surfer-max/SpotNik/F2TUN2BKOZRGQVP.jpg

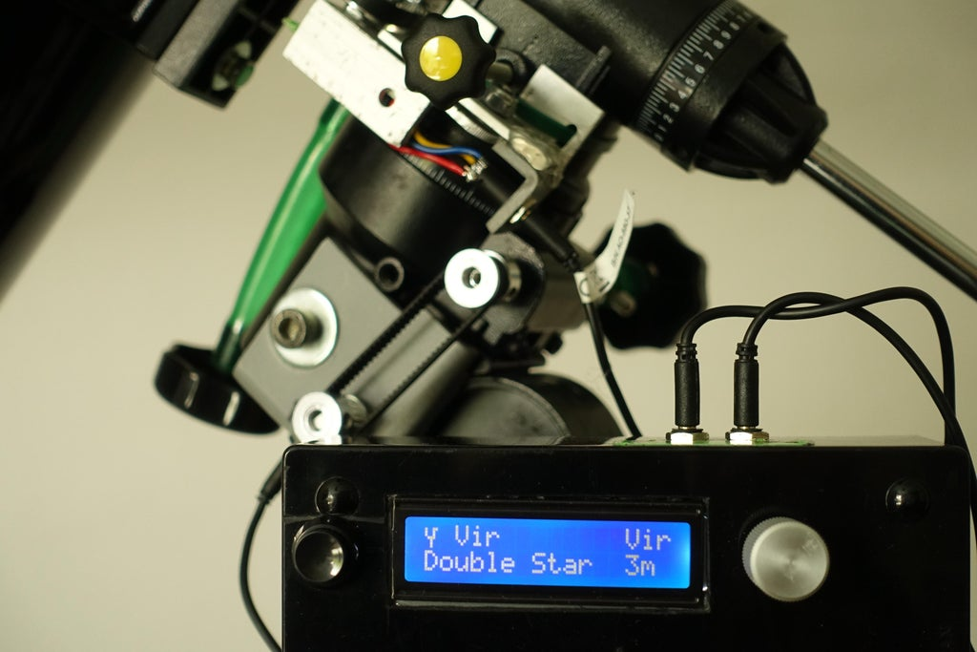
F2TUN2BKOZRGQVP.jpg
