surfer-max/SpotNik/FJV54ZKKOZRGQVQ.jpg

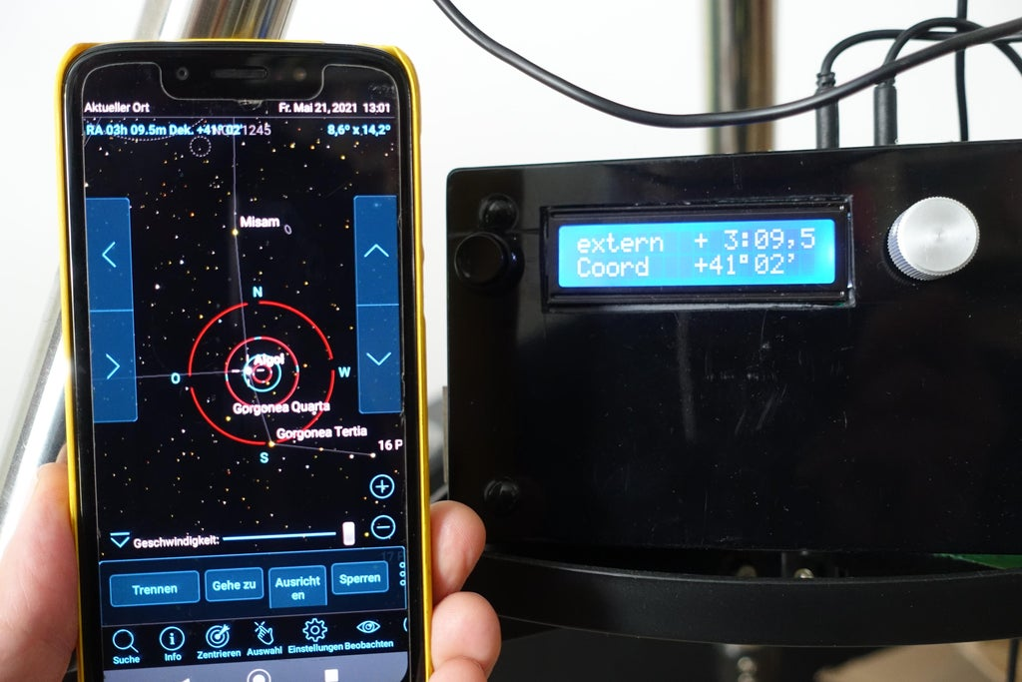
FJV54ZKKOZRGQVQ.jpg
