surfer-max/SpotNik/spotnik.ino

 /* ///////////////////////////////////////////////////////////////////////////////////
  SpotNik - by Max Reinecke 
  Created: May 2021
  SpotNik is software for a stepto system for telescopes

    This program is free software: you can redistribute it and/or modify
    it under the terms of the GNU General Public License as published by
    the Free Software Foundation, either version 3 of the License, or
    (at your option) any later version.
    This program is distributed in the hope that it will be useful,
    but WITHOUT ANY WARRANTY; without even the implied warranty of
    MERCHANTABILITY or FITNESS FOR A PARTICULAR PURPOSE.  See the
    GNU General Public License for more details.
    You should have received a copy of the GNU General Public License
    along with this program.  If not, see <http://www.gnu.org/licenses/>.
  /////////////////////////////////////////////////////////////////////////////////*/
#define VERSION 2.0

//###############################################################################################################
// to be changed by user according to EQ mount - see instructions
// total numbers of impulse of the rotary encoder of RA axis when turned 24h 
#define IMPULSE24HRA 2772 // 6h - 690 Impulse --> 24h - 4 * 693 = 2772 / ~ 1:138
//  total numbers of impulse of the rotary encoder of DEC axis when turned 360° // +/- for correct direction 
#define IMPULSE360DEGDEC 1784  // 90° - 446 Impulse --> 360° - 4 * 446 = 1784 / ~ 1:88
//###############################################################################################################

#include <LiquidCrystal.h> // I2C LCD arbeitet nicht vernünftig mit Rotary Encoder zusammen,daher normales nehmen
#include <EEPROM.h> 
//#include <MemoryFree.h> // only used for testing

//###############################################################################################################
// LCD
#define LCD_CONTRAST_PIN 11 //  LCD contrast - V0 // use high frequency PWM to avoid flickering (Leonardo,Micro,Yún 3 and 11: 980 Hz // Mega pins 4 and 13: 980 Hz) 
#define LCD_BACKLIGHT_PIN 10 // LCD backlight - LCD A

// EEPROM
#define EEPROM_SIGNATURE 117 // value 0-255 (byte) - signature/mark to recognize if the value fits to this sketch
#define EEPROM_VALUE_ADDR_SIGNATURE 0 

// rotary enoder HMI 
#define ROTARY_SW 3 // use interrupt pin - digital pins for interrupts on Micro,Leonardo and other 32u4 based 0,1,2,3,7
#define ROTARY_DT 4 
#define ROTARY_CLK 5 

// Sensor RA
#define SENS_RA_DT A0 // analog pins used as UNO has not that many digital pins
#define SENS_RA_CLK A1 

// Sensor DEC
#define SENS_DEC_DT A2 
#define SENS_DEC_CLK A3 

// LX200 connection
#define BT_SWITCH 2

//###############################################################################################################
// lookup table with names of deep sky objects
//###############################################################################################################
struct DSONameStruct
{
  char objectName[9];
};

const struct DSONameStruct DSO_NAME_PROGMEM[202] PROGMEM = 
{
{"3C273"},
{"B"},
{"IC"},
{"M"},
{"NGC"},
{"#a"},
{"#aA"},
{"#aB"},
{"#b"},
{"#c"},
{"#d"},
{"#e"},
{"#e1"},
{"#e2"},
{"#g"},
{"#h"},
{"#i"},
{"#j"},
{"#k"},
{"#l"},
{"#m"},
{"#n"},
{"#o"},
{"#p"},
{"#q"},
{"#r"},
{"#s"},
{"#t"},
{"#u"},
{"#w"},
{"#x"},
{"#z"},
{"AC"},
{"Achernar"},
{"Acrab"},
{"Acrux"},
{"Adhara"},
{"Agena"},
{"Alamak"},
{"Aldebara"},
{"Alderami"},
{"AlDhanab"},
{"Algenib"},
{"Algieba"},
{"Algol"},
{"Alhena"},
{"Alioth"},
{"Alkaid"},
{"AlNair"},
{"Alnilam"},
{"Alnitak"},
{"Alphard"},
{"Alphecca"},
{"Alpherat"},
{"Alsuhail"},
{"Altair"},
{"Aludra"},
{"Ankaa"},
{"Antares"},
{"AQ"},
{"Arcturus"},
{"Arneb"},
{"Aspidisk"},
{"Atria"},
{"Avior"},
{"AW"},
{"AX"},
{"BD"},
{"Becrux"},
{"Bellatri"},
{"Betelgeu"},
{"BF"},
{"BG"},
{"BL"},
{"BM"},
{"BX"},
{"Canopus"},
{"Capella"},
{"Caph"},
{"Castor"},
{"Cih"},
{"CY"},
{"Deneb"},
{"DenebKai"},
{"Denebola"},
{"Diphda"},
{"DR"},
{"Dschubba"},
{"Dubhe"},
{"EL"},
{"ElNath"},
{"Eltanin"},
{"Enif"},
{"FO"},
{"Fomalhau"},
{"FU"},
{"Gacrux"},
{"Gemma"},
{"Gienah"},
{"Girtab"},
{"GK"},
{"GY"},
{"H"},
{"Hadar"},
{"Hamal"},
{"Han"},
{"HD"},
{"HJ"},
{"HK"},
{"HN"},
{"Izar"},
{"JC"},
{"KausAust"},
{"Kochab"},
{"KooShe"},
{"Markab"},
{"Menkalin"},
{"Menkar"},
{"Menkent"},
{"Merak"},
{"Miaplaci"},
{"Mimosa"},
{"Mintaka"},
{"Mirach"},
{"Mirfak"},
{"Mirzam"},
{"Mizar"},
{"Naos"},
{"NQ"},
{"NSV"},
{"Nunki"},
{"O#F"},
{"Peacock"},
{"Phecda"},
{"Polaris"},
{"Pollux"},
{"Procyon"},
{"PZ6"},
{"R"},
{"RasAlhag"},
{"Regulus"},
{"Rigel"},
{"RigilKen"},
{"RR"},
{"RS"},
{"RT"},
{"RU"},
{"RV"},
{"RX"},
{"RY"},
{"RZ"},
{"S"},
{"S605"},
{"Sabik"},
{"Sadr"},
{"Saiph"},
{"SAO"},
{"Sargas"},
{"Scheat"},
{"Schedar"},
{"Shaula"},
{"SHJ"},
{"Sirius"},
{"Spica"},
{"SS"},
{"ST"},
{"SU"},
{"SV"},
{"SY"},
{"SZ"},
{"T"},
{"TT"},
{"TU"},
{"Tureis"},
{"TW"},
{"TX"},
{"U"},
{"UU"},
{"UV"},
{"UX"},
{"UY"},
{"V"},
{"Vega"},
{"VW"},
{"VX"},
{"VY"},
{"W"},
{"Wei"},
{"Wezen"},
{"WO"},
{"WW"},
{"WX"},
{"WZ"},
{"X"},
{"XS"},
{"XX"},
{"Y"},
{"Z"},
{"Zozma"},
{"β648"},
{"#F"},
{"extern"}
};
//###############################################################################################################

//###############################################################################################################
// data of deep sky objects
//###############################################################################################################
struct DSOstruct
{
  byte objectPreFixNameNo; // number of name for lookup table
  unsigned int objectNumber; // if name contains a number
  byte objectTypeMagnitude; // object type & magnitude coded in one byte
  byte objectConst; // constellation of object
  unsigned int objectRA; //HHMM(SS/6)
  int objectDEC; //sHHMM
};

DSOstruct myTarget; // object to store data of selected target
DSOstruct myReference; // object to store data of selected target

const unsigned int DSO_PROGMEM_size = 1204;
const struct DSOstruct DSO_PROGMEM[DSO_PROGMEM_size] PROGMEM = 
{
{1, 0, 27, 86, 12291, 203},
{2, 33, 42, 60, 5409, -228},
{2, 65, 42, 77, 18027, -2750},
{2, 86, 42, 59, 17196, -2642},
{3, 342, 54, 11, 3468, 6806},
{3, 405, 66, 8, 5165, 3421},
{3, 410, 64, 8, 5227, 3325},
{3, 434, 67, 60, 5410, -227},
{3, 1396, 74, 16, 21391, 5730},
{3, 4406, 95, 50, 14224, -4409},
{3, 5067, 64, 31, 20508, 4421},
{3, 5146, 80, 31, 21534, 4716},
{4, 1, 106, 78, 5345, 2201},
{4, 2, 119, 5, 21335, -49},
{4, 3, 118, 30, 13422, 2823},
{4, 4, 117, 72, 16236, -2632},
{4, 5, 118, 74, 15186, 205},
{4, 6, 130, 72, 17403, -3215},
{4, 7, 129, 72, 17539, -3448},
{4, 8, 75, 77, 18037, -2423},
{4, 9, 120, 59, 17192, -1831},
{4, 10, 119, 59, 16571, -406},
{4, 11, 132, 73, 18511, -616},
{4, 12, 118, 59, 16472, -157},
{4, 13, 118, 40, 16417, 3628},
{4, 14, 120, 59, 17376, -315},
{4, 15, 118, 62, 21300, 1210},
{4, 16, 76, 74, 18188, -1347},
{4, 17, 76, 77, 18208, -1611},
{4, 18, 133, 77, 18199, -1708},
{4, 19, 119, 59, 17026, -2616},
{4, 20, 76, 77, 18027, -2258},
{4, 21, 132, 77, 18042, -2229},
{4, 22, 117, 77, 18364, -2354},
{4, 23, 132, 77, 17571, -1859},
{4, 24, 129, 77, 18266, -1823},
{4, 25, 131, 77, 18318, -1907},
{4, 26, 134, 73, 18452, -924},
{4, 27, 91, 88, 19596, 2243},
{4, 28, 119, 77, 18245, -2452},
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
};
//###############################################################################################################

//###############################################################################################################
// variables for button - instead of bounce lib - save flash memory
//###############################################################################################################
const int DEBOUNCE_DELAY = 50;   // the debounce time; increase if the output flickers
int lastSteadyState = LOW;       // the previous steady state from the input pin
int lastFlickerableState = LOW;  // the previous flickerable state from the input pin
int currentState;                // the current reading from the input pin
unsigned long lastDebounceTime = 0;  // the last time the output pin was toggled
unsigned long lastPressedTime = 0;
//###############################################################################################################

//###############################################################################################################
// LCD - VSS - GND // VCC - 5V // RW - GND // K - GND
//###############################################################################################################
const byte rs = 12;
const byte en = 13;
const byte d4 = 9; 
const byte d5 = 8; 
const byte d6 = 7; 
const byte d7 = 6; 
LiquidCrystal lcd(rs,en,d4,d5,d6,d7);
byte myLCDbacklight = 255;
byte myLCDcontrast = 100;
//###############################################################################################################

//###############################################################################################################
// variables to steer menu
//###############################################################################################################
byte myDisplayMode = 0; 
const char *const menuTopic[] = {"DEC", "Align","Target","Region","Const","Brightness","Contrast","Sensors","LX200"};
const byte menuTopic_size = sizeof(menuTopic) / sizeof(menuTopic[0]);
byte myMenuTopicNo = 0;
//###############################################################################################################

//###############################################################################################################
// definition of special / greek characters - for LCD 1602 chinese version - adapt to your LCD if needed
//###############################################################################################################
// used lcd is like this https://www.waveshare.com/datasheet/LCD_en_PDF/LCD1602.pdf (see 14. font table)
const char ch_deg = (char)(223); // degree symbol 
const char ch_sigma = (char)(246); // uppercase Sigma 
// greek alphabet 1-24 = α β γ δ ε ζ η θ ι κ λ μ ν ξ ο π ρ σ τ υ φ χ ψ ω
// maximum 8 custom characters
// γ
char ch_def_1 = 'g'; // for identificatrion & replacement
byte ch_custom_1[] = {
  B00000,
  B10011,
  B10010,
  B10010,
  B01110,
  B00100,
  B00100,
  B00100
};
// δ
char ch_def_2 = 'd';
byte ch_custom_2[] = {
  B00110,
  B01001,
  B00100,
  B01110,
  B10001,
  B10001,
  B01110,
  B00000
};
// ζ
char ch_def_3 = 'z';
byte ch_custom_3[] = {
  B01111,
  B00010,
  B00100,
  B01000,
  B01000,
  B01111,
  B00001,
  B00110
};
// λ
char ch_def_4 = 'l';
byte ch_custom_4[] = {
  B01100,
  B00100,
  B00100,
  B01010,
  B01010,
  B10001,
  B10001,
  B00000
};
// ξ
char ch_def_5 = 'x';
byte ch_custom_5[] = {
  B11111,
  B00100,
  B01000,
  B00111,
  B01000,
  B10000,
  B11111,
  B00010
};
// φ
char ch_def_6 = 'p';
byte ch_custom_6[] = {
  B00000,
  B10111,
  B10101,
  B10101,
  B10101,
  B01110,
  B00100,
  B00100
};
// ψ
char ch_def_7 = 's';
byte ch_custom_7[] = {
  B00000,
  B00100,
  B10101,
  B10101,
  B10101,
  B01110,
  B00100,
  B00100
};
// Δ
char ch_def_8 = 'D';
byte ch_custom_8[] = {
  B00000,
  B00100,
  B01010,
  B01010,
  B10001,
  B10001,
  B11111,
  B00000
};

// lookup table placeholder chars with greek symbols
struct greekSymbols {
  char originalChar;
  char replaceChar;  
};

const unsigned int greekSymbols_size = 26;
const struct greekSymbols greekSymbols[greekSymbols_size]  = 
{
  {'a',(char)(224)},// α
  {'b',(char)(226)},// β 
  {'g','g'},// γ custom character
  {'d','d'},// δ custom character
  {'e',(char)(227)},// ε
  {'z','z'},// ζ custom character
  {'j','n'},// η
  {'h',(char)(242)},// θ
  {'i','l'},// ι
  {'k','k'},// κ
  {'l','l'},// λ custom character
  {'m',(char)(228)},// μ
  {'n','v'},// ν
  {'x','x'},// ξ custom character
  {'o','o'},// ο
  {'p',(char)(247)},// π
  {'r',(char)(230)},// ρ
  {'s',(char)(229)},// σ
  {'t','t'},// τ
  {'y',(char)(232)},// υ
  {'q','p'},// φ custom character
  {'c','x'},// χ
  {'w','s'},// ψ custom character
  {'u','w'},
  {'F',(char)(246)},// Σ
  {'D','/'} // Δ
}; 
//###############################################################################################################  

//###############################################################################################################
// definition of constellation names
//###############################################################################################################
struct constStruct { char constName[4];};
constStruct myConstellation;
const unsigned int constStruct_size = 89;
const struct constStruct const_PROGMEM[constStruct_size] PROGMEM = {
{"all"},{"And"},{"Ant"},{"Aps"},{"Aql"},{"Aqr"},{"Ara"},{"Ari"},{"Aur"},{"Boo"},{"Cae"},{"Cam"},{"Cap"},{"Car"},{"Cas"},{"Cen"},{"Cep"},{"Cet"},{"Cha"},{"Cir"},
{"CMa"},{"CMi"},{"Cnc"},{"Col"},{"Com"},{"CrA"},{"CrB"},{"Crt"},{"Cru"},{"Crv"},{"CVn"},{"Cyg"},{"Del"},{"Dor"},{"Dra"},{"Equ"},{"Eri"},{"For"},{"Gem"},{"Gru"},
{"Her"},{"Hor"},{"Hya"},{"Hyi"},{"Ind"},{"Lac"},{"Leo"},{"Lep"},{"Lib"},{"LMi"},{"Lup"},{"Lyn"},{"Lyr"},{"Men"},{"Mic"},{"Mon"},{"Mus"},{"Nor"},{"Oct"},{"Oph"},
{"Ori"},{"Pav"},{"Peg"},{"Per"},{"Phe"},{"Pic"},{"PsA"},{"Psc"},{"Pup"},{"Pyx"},{"Ret"},{"Scl"},{"Sco"},{"Sct"},{"Ser"},{"Sex"},{"Sge"},{"Sgr"},{"Tau"},{"Tel"},
{"TrA"},{"Tri"},{"Tuc"},{"UMa"},{"UMi"},{"Vel"},{"Vir"},{"Vol"},{"Vul"}};
byte myConstellationNo = 0;
String myConstellationName = ""; 
//###############################################################################################################

//###############################################################################################################
// object type name and variables for deep sky objects
//###############################################################################################################
const char* myObjectTypeName[]={"Quasar","Dark Nebula","Galaxy","Bright Neb","Clust + Neb","Planet Neb","SN Rem","Glob Cluster","Open Cluster","Double Star","Red Star","Reference","any"};
unsigned int myRefNo = 0; // number of selected reference star 
unsigned int  myTargetNo = 0; // number of selected target
//###############################################################################################################

//###############################################################################################################
// definition of cellestial regions = constellations of seasons defined in groups (as in Deep Sky Atlas) to filter targets and reference stars 
//###############################################################################################################
// constellation for which deep sky objects exist in the list 0 = all
const byte myAllCONST[]={0,1,2,4,5,6,7,8,9,11,12,13,14,15,16,17,19,20,21,22,23,24,25,26,27,28,29,30,31,32,33,34,35,36,37,38,39,40,41,42,44,45,46,47,48,49,50,51,52,54,55,57,59,60,61,62,63,64,66,67,68,69,71,72,73,74,75,76,77,78,80,81,83,84,85,86,88};
const byte myAllCONST_size = sizeof(myAllCONST) / sizeof(myAllCONST[0]);
// North - UMI,UMA,DRA,CEP,CAS,CAM
const byte myNorthCONST[]={84,83,34,16,14,11};
const byte myNorthCONST_size = sizeof(myNorthCONST) / sizeof(myNorthCONST[0]);
// Spring - LEO,LMI,SEX,HYA,CVN,COM,VIR,CRT,CRV,BOO,CRB,SER
const byte mySpringCONST[]={46,49,75,42,30,24,86,27,29,9,26,74};
const byte mySpringCONST_size = sizeof(mySpringCONST) / sizeof(mySpringCONST[0]);
// Summer - HER,LYR,OPH,SCO,CYG,VUL,SGE,DEL,EQU,AQL,SCT,SER,SGR,CAP
const byte mySummerCONST[]={40,52,59,72,31,88,76,32,35,4,73,74,77,12};
const byte mySummerCONST_size = sizeof(mySummerCONST) / sizeof(mySummerCONST[0]);
// Autumn - LAC,PEG,AQR,PSA,AND,TRI,PER,ARI,PSC,CET,SCL,FOR,ERI
const byte myAutumnCONST[]={45,62,5,66,1,81,63,7,67,17,71,37,36};
const byte myAutumnCONST_size = sizeof(myAutumnCONST) / sizeof(myAutumnCONST[0]);
// Winter - AUR,TAU,ORI,LEP,LYN,GEM,CMI,MON,CMA,PUP,CNC
const byte myWinterCONST[]={8,78,60,47,51,38,21,55,20,68,22};
const byte myWinterCONST_size = sizeof(myWinterCONST) / sizeof(myWinterCONST[0]);
// South - ANT,VEL,CAR,VOL,CHA,MUS,CRU,CEN,CRU,TRA,LUP,NOR,ARA,SCO,SGR,CRA,TEL,MIC,IND,PAV,GRU,PHE,SCL,FOR,ERI,HOR,RET,HYI,TUC,DOR,CAE,COL,PUP,PYX,PIC,MEN,APS,OCT
const byte mySouthCONST[]={2,85,13,28,15,28,80,50,57,6,72,77,25,54,44,61,39,64,71,37,36,41,33,23,68,69,65};
const byte mySouthCONST_size = sizeof(mySouthCONST) / sizeof(mySouthCONST[0]);
const char* myregionNAME[]={"all","North","Spring","Summer","Autumn","Winter","South"}; // no south to save flash
const byte regionArraySize = sizeof(myregionNAME) / sizeof(myregionNAME[0]); // Anzahl der Einträge
byte myRegionNo = 0; // all - 0; North - 1; .... ; South - 6
String myregionName = "";
//###############################################################################################################

//###############################################################################################################
// variables for calculation of position // all positions are calculated in seconds
//###############################################################################################################
long myRefStartTimeSec = 0; // Startzeit beim Setzen des Referenzsterns in Sekunden
long myCurrentRAsec = 0; // meine aktuelle Rektaszension in Sekunden
long myCurrentDECsec = 0; // meine aktuelle Deklination in Sekunden
long myLastRAsec = 0; // meine letzte Rektaszension in Sekunden 
long myLastDECsec = 0; // meine letzte Deklination in Sekunden 
long myReferenceRAsec = 0; // meine Rektaszensionsreferenz in Sekunden
long myReferenceDECsec = 0; // meine Deklinationsreferenz in Sekunden
long mySensorRAsec = 0; // Sensorwert der Rektaszension in Sekunden
long mySensorDECsec = 0; // Sensorwert der Deklination in Sekunden
long myTargetRAsec = 0; // Rektaszension des Ziels in Sekunden
long myTargetDECsec = 0; // Deklination des Ziels in Sekunden
const int secPerStepRA = 86400L / IMPULSE24HRA; // defines how many seconds RA is changed per rotary step //  (24h * 3600sec = 86400sec) / (1:139 * 20 impulse = 2780) --> 31,079 sec / i
const int secPerStepDEC = 1296000L / IMPULSE360DEGDEC; // defines how many seconds DEC is changed per rotary step //  (360° * 3600sec = 1296000sec) / (1:96 * 20 impulse = 1920) / --> 675 sec / i
int myDirectionDEC = 1; // saves the value of the direction of the DEC axis, important if the telescope is turned over
//###############################################################################################################

//###############################################################################################################
// for rotary encoders
//###############################################################################################################
static uint8_t prevNextCode_ROT = 0;
static uint16_t store_ROT=0;
static uint8_t prevNextCode_RA = 0;
static uint16_t store_RA=0;
static uint8_t prevNextCode_DEC = 0;
static uint16_t store_DEC=0;
static int8_t val_ROT,val_RA,val_DEC; 
int myImpulseRA = 0,myImpulseDEC = 0;
int myLastImpulseRA = 0,myLastImpulseDEC = 0;
const int8_t enc_table[] = {0,1,1,0,1,0,0,1,1,0,0,1,0,1,1,0};
//###############################################################################################################

//###############################################################################################################
// variables for LX200
//###############################################################################################################
byte statusLX200 = 0; // 0 - BT switched off / 1 - BT switched on / 2 - connected via BT & LX200 (frequent connect to LX200)
byte statusLX200old = 0;
byte btStatus = 0; // 0 - off / 1 - on
unsigned long lastLX200Message = 0;
DSOstruct externalObject; // instance LX200 object
//###############################################################################################################

//###############################################################################################################
// setup
//###############################################################################################################
void setup()
{
  // for LX200 protocol & debugging
  Serial.begin (9600);
 // while(!Serial); // attention - only for debugging when in use with IDE!
 // Serial.println(F("started"));

  getSettingsFromEeprom(); // load settings (brightness,contrast,...)
  setReference(); // set reference object to saved values
  setTarget(); // set target object to saved values
  setupLCD();
  createCustomCharacters();
  setupRotaryEncoders();
  initExternalObject();
}

// software reset https://www.instructables.com/two-ways-to-reset-arduino-in-software/
void(* resetFunc) (void) = 0;//declare reset function at address 0

void setupLCD()
{
  lcd.begin(16,2);
  updateLCD();   
  pinMode(LCD_BACKLIGHT_PIN,OUTPUT);
  analogWrite(LCD_CONTRAST_PIN, myLCDcontrast); //set contrast
}

//Creating custom characters in CG-RAM
void createCustomCharacters()
{
  lcd.createChar(1 ,ch_custom_1); 
  lcd.createChar(2 ,ch_custom_2); 
  lcd.createChar(3 ,ch_custom_3); 
  lcd.createChar(4 ,ch_custom_4); 
  lcd.createChar(5 ,ch_custom_5); 
  lcd.createChar(6 ,ch_custom_6); 
  lcd.createChar(7 ,ch_custom_7);  
  lcd.createChar(8 ,ch_custom_8); 
}

void setupRotaryEncoders()
{
  // HMI rotary encoder button
  pinMode(ROTARY_SW,INPUT_PULLUP); 

  // HMI rotary encoder
  pinMode(ROTARY_CLK,INPUT);
  pinMode(ROTARY_DT,INPUT);

  // it is better to use the integrated pull-ups of KY-040 (this requires "+" to be connected to 5V) - https://forum.arduino.cc/index.php?topic=242356.0 
  // as analog pins are used for rotary encoders - internal pull-ups are additionally used to avoid akward behaviour if not connected to sensors
  // RA rotary encoder
  pinMode(SENS_RA_CLK,INPUT_PULLUP);
  pinMode(SENS_RA_DT,INPUT_PULLUP);
  // DEC rotary encoder
  pinMode(SENS_DEC_CLK,INPUT_PULLUP);
  pinMode(SENS_DEC_DT,INPUT_PULLUP); 

  // switch for BT module
  pinMode(BT_SWITCH, OUTPUT);   
}

// initialise external object struct for receiving via LX200
void initExternalObject()
{
  externalObject.objectPreFixNameNo = 202; // is "external" in DSO PROGMEM
  externalObject.objectNumber = 0; // empty - no number in name
  externalObject.objectTypeMagnitude = 0; 
  externalObject.objectConst = 0; // "all" in constellations
  externalObject.objectRA = 0;
  externalObject.objectDEC = 0;
}
//###############################################################################################################
// \setup
//###############################################################################################################

//###############################################################################################################
// loop
//###############################################################################################################
void loop()
{
  analogWrite(LCD_BACKLIGHT_PIN,myLCDbacklight);   // LCD backlight analogWrite: values from 0 to 255

  updateRotaryEncoderButton();
  updateRotaryEncoders();
  calcCurrentPosition();
  
  if (myDisplayMode == 9) displaySensorValue();
  if (myDisplayMode == 11) displayCurrPos(); 
  if (myDisplayMode == 12) displayTargetPos();
  if (myDisplayMode == 13) displayDiffTargetCurrPos();

  // LX200 status
  updateLX200Status();
  readSendLX200(); 
}
//###############################################################################################################
// \loop
//###############################################################################################################

//###############################################################################################################
// read sensor values
//###############################################################################################################
// reads rotary encoders
void updateRotaryEncoders()
{
  if(val_ROT=read_rotary_ROT()) switchSelection(val_ROT); 
  
  if(val_RA=read_rotary_RA()) 
  {
    mySensorRAsec = mySensorRAsec + val_RA * secPerStepRA;
    myImpulseRA = myImpulseRA + val_RA; // for sensor test
  }
  
  if(val_DEC=read_rotary_DEC()) 
  {
    mySensorDECsec = mySensorDECsec + val_DEC * secPerStepDEC * myDirectionDEC; 
    myImpulseDEC = myImpulseDEC + val_DEC * myDirectionDEC; // for sensor test
  }
}

// reads rotary encoder button
void updateRotaryEncoderButton()
{
  // copy from https://arduinogetstarted.com/tutorials/arduino-button-debounce
  currentState = digitalRead(ROTARY_SW);

  if (currentState != lastFlickerableState) 
  {
    lastDebounceTime = millis();
    lastFlickerableState = currentState;
  }

  if ((millis() - lastDebounceTime) > DEBOUNCE_DELAY) 
  {
    if(lastSteadyState == HIGH && currentState == LOW)
    {
      switchMode();
      updateLCD();
      lastPressedTime = millis();
    }
    else if(lastSteadyState == LOW && currentState == HIGH)
    {
      // if button pressed > 5 seconds -> reset
      if (millis() - lastPressedTime > 5000) resetFunc(); // call reset
    }
    lastSteadyState = currentState;
  } 
}

// read rotary encoder for HMI
// robust rotary encoder reading https://www.best-microcontroller-projects.com/rotary-encoder.html
// A vald CW or  CCW move returns 1,invalid returns 0.
int8_t read_rotary_ROT() 
{
  prevNextCode_ROT <<= 2;
  if (digitalRead(ROTARY_DT)) prevNextCode_ROT |= 0x02;
  if (digitalRead(ROTARY_CLK)) prevNextCode_ROT |= 0x01;
  prevNextCode_ROT &= 0x0f;

  // If valid then store as 16 bit data.
  if  (enc_table[prevNextCode_ROT] ) 
  {
    store_ROT <<= 4;
    store_ROT |= prevNextCode_ROT;
    if ((store_ROT&0xff)==0x2b) return -1;
    if ((store_ROT&0xff)==0x17) return 1;
  }
  return 0;
}

// read rotary encoder for RA
int8_t read_rotary_RA() 
{
  prevNextCode_RA <<= 2;
  if (digitalRead(SENS_RA_DT)) prevNextCode_RA |= 0x02;
  if (digitalRead(SENS_RA_CLK)) prevNextCode_RA |= 0x01;
  prevNextCode_RA &= 0x0f;

  // If valid then store as 16 bit data.
  if  (enc_table[prevNextCode_RA] ) 
  { 
    store_RA <<= 4;
    store_RA |= prevNextCode_RA;
    if ((store_RA&0xff)==0x2b) return -1;
    if ((store_RA&0xff)==0x17) return 1;
  }
  return 0;
}

// read rotary encoder for DEC
int8_t read_rotary_DEC() 
{
  prevNextCode_DEC <<= 2;
  if (digitalRead(SENS_DEC_DT)) prevNextCode_DEC |= 0x02;
  if (digitalRead(SENS_DEC_CLK)) prevNextCode_DEC |= 0x01;
  prevNextCode_DEC &= 0x0f;

  // If valid then store as 16 bit data.
  if  (enc_table[prevNextCode_DEC] ) 
  {
    store_DEC <<= 4;
    store_DEC |= prevNextCode_DEC;
    if ((store_DEC&0xff)==0x2b) return -1;
    if ((store_DEC&0xff)==0x17) return 1;
  }
  return 0;
}
//###############################################################################################################
// read sensor values
//###############################################################################################################


//###############################################################################################################
// get & set of object data
//###############################################################################################################
// returns the type as number of a deep sky object
byte getObjectType(byte typeMagnitude)
{
  return (typeMagnitude / 14); // decoding of object type from typeMagnitude
}

// returns the type as string of a deep sky object
String getObjectTypeName(byte typeMagnitude)
{
  return myObjectTypeName[(typeMagnitude / 14) - 1];
}

// returns the magnitude of a deep sky object
String getMagnitude(byte typeMagnitude)  // calcs the right magnitude - here modulo 14 as coded 
{
  String strFlMag = (String)(typeMagnitude % 14) +  "m";
  return strFlMag; 
}

// returns the name of a constellation as string from a lookup tabel according to its number
String getConstName(int no)
{ 
  constStruct oneConstellation;
  // copy constellations data from PROGMEM into oneConstellation according to no
  memcpy_P (&oneConstellation,&const_PROGMEM[no],sizeof oneConstellation); 
  return (String)oneConstellation.constName;
}

// returns the current constellation for filtering
String getCurrentConstName()
{
  String constellationName;
  constellationName = getConstName(myConstellationNo);
  return constellationName;
}

// returns the current cellestial region
String getSetregionName()
{
  return myregionNAME[myRegionNo];
}

// set reference star
void setReference()
{
  // copy reference data from PROGMEM into myReference according to myRefNo
  memcpy_P (&myReference,&DSO_PROGMEM[myRefNo],sizeof myReference); 
  setReferenceRA_DEC();
}

// RA and DEC of selected target are set
void setReferenceRA_DEC()
{
  // transfer RA / DEC into internal format (seconds)
  myReferenceRAsec = calcRAsecFromRA(myReference.objectRA);
  myReferenceDECsec = calcDECsecFromDEC(myReference.objectDEC);
}

// set target
void setTarget()
{
  // copy reference data from PROGMEM into myTarget according to myTargetNo
  memcpy_P (&myTarget,&DSO_PROGMEM[myTargetNo],sizeof myTarget); 
  setTargetRA_DEC();
}

// RA and DEC of selected target are set
void setTargetRA_DEC()
{
  // transfer RA / DEC into internal format (seconds)
  myTargetRAsec = calcRAsecFromRA(myTarget.objectRA);
  myTargetDECsec = calcDECsecFromDEC(myTarget.objectDEC);
}
//###############################################################################################################
// \get & set of object data
//###############################################################################################################

//###############################################################################################################
// calculations and settings of positions
//###############################################################################################################

// calculation of RA seconds 
unsigned int calcRAsecFromRA(unsigned int ra)
{
    int h = ra / 1000;
    int m = (ra - h * 1000) / 10;
    int s = (ra - h * 1000 - m * 10) * 6;
    unsigned int raSec = h * 3600L + m * 60 + s;
    return raSec;
}

// calculation of DEC seconds
long calcDECsecFromDEC(int dec)
{
    int deg = dec / 100;
    int m = (dec - deg * 100);
    long decSec = deg * 3600L + m * 60;
    return decSec;
}

// calculation of current telescope position
void calcCurrentPosition()
{
   myCurrentRAsec = myReferenceRAsec + myRefStartTimeSec + mySensorRAsec - millis()/1000;
   myCurrentDECsec = myReferenceDECsec + mySensorDECsec;
}

// sets the sensor values to zero - needed for alignment with reference star
void resetSensorTime()
{
    mySensorRAsec = 0; // Sensorwert der Rektaszension
    mySensorDECsec = 0; // Sensorwert der Deklination
    myRefStartTimeSec = millis() / 1000;
}
//###############################################################################################################
// \calculations and settings of positions
//###############################################################################################################

//###############################################################################################################
// display information
//###############################################################################################################

// display the current position
void displayCurrPos()
{
   if (myLastRAsec != myCurrentRAsec || myLastDECsec != myCurrentDECsec)
   {
       myLastRAsec = myCurrentRAsec;
       myLastDECsec = myCurrentDECsec;
       displayRA_DEC("Curr   ","Coord",myCurrentRAsec,myCurrentDECsec);
   }
}

// display position of selected target
void displayTargetPos()
{
  displayRA_DEC(getObjectName(myTarget.objectPreFixNameNo,myTarget.objectNumber,myTarget.objectConst),"Coord",myTargetRAsec,myTargetDECsec);
}

// calulation & display of difference between current position & target position
void displayDiffTargetCurrPos()
{
  long diffRAsec = myTargetRAsec - myCurrentRAsec;
  long diffDECsec = myTargetDECsec - myCurrentDECsec; 

  if (myLastRAsec != myCurrentRAsec ||  myLastDECsec != myCurrentDECsec) // only if position has changed
  {
     myLastRAsec = myCurrentRAsec;
     myLastDECsec = myCurrentDECsec;
     displayRA_DEC(getObjectName(myTarget.objectPreFixNameNo,myTarget.objectNumber,myTarget.objectConst),"Diff ",diffRAsec ,diffDECsec);
  }
}

// display of RA and DEC - generic use for reference stars & target
void displayRA_DEC(String text1,String text2,long rekSec,long dekSec)
{
    // Rektaszension // 
    int sign = 1.0;
    if (rekSec < 0) sign = -1.0;
    byte s = (abs(rekSec)) % 60; // Das Zeichen: "%" ist der Modulo-Operator // vorher int
    byte m  = (abs(rekSec/60)) % 60;
    byte h  = (abs(rekSec/3600)) % 24;

    lcd.setCursor(0,0);
    printObjectName(text1);
    lcd.setCursor(8,0);
    if (sign<0) lcd.print(F("-"));
    else lcd.print(F("+"));
    if (h<10) lcd.print(F(" ")); 
    lcd.print(h);
    lcd.print(F(":"));
    if (m<10) lcd.print(F("0"));
    lcd.print(m);
    lcd.print(F(","));
    lcd.print(s/6);

    // DEC // +90° - -90°
    sign = 1.0;
    if (dekSec < 0) sign = -1.0;
    s = (abs(dekSec)) % 60; // Das Zeichen: "%" ist der Modulo-Operator
    m = (abs(dekSec/60)) % 60;
    h = (abs(dekSec/3600)) % 180;
    
    lcd.setCursor(0,1);
    lcd.print(text2);
    lcd.setCursor(8,1);    
    if (sign<0) lcd.print(F("-"));
    else lcd.print(F("+"));
    if (h<10)   lcd.print(F(" ")); 
    lcd.print(h);
    lcd.print(ch_deg);
    if (m<10) lcd.print(F("0"));
    lcd.print(m);
    lcd.print(F("'"));
}

// display current sensor values
void displaySensorValue()
{
  if (myImpulseRA != myLastImpulseRA || myImpulseDEC != myLastImpulseDEC)
  {
    lcd.clear();
    lcd.setCursor(0,0);
    lcd.print(F("Imp RA"));
    lcd.setCursor(0,1);
    lcd.print(F("Imp DEC"));
    lcd.setCursor(10,0);
    lcd.print(myImpulseRA);
    lcd.setCursor(10,1);
    lcd.print(myImpulseDEC);
    myLastImpulseRA = myImpulseRA;
    myLastImpulseDEC = myImpulseDEC;
  }
}

// update LCD according to selected display mode
void updateLCD()
{
  lcd.clear();
  lcd.setCursor(0,0);
  
  if (myDisplayMode == 0)
  {
    lcd.print(F("SpotNik   v")); // DO NOT REMOVE
    lcd.print(VERSION);   
    lcd.setCursor(0,1);
    lcd.print(F("developed by MR")); // DO NOT REMOVE
  }
  if (myDisplayMode == 1) // main menu
  {  
    lcd.print(F(">"));
    lcd.setCursor(1,0);
    lcd.print(menuTopic[myMenuTopicNo]); // {" reverse", "Ref","Target","region","Const","Bright","Contr","Test"};
    lcd.setCursor(8,0);
    
    switch (myMenuTopicNo) {
      case 0:
        if (myDirectionDEC == 1) lcd.print(F("normal"));
        else lcd.print(F("reverse"));
      break;
      case 1:
        printObjectName(getObjectName(myReference.objectPreFixNameNo,myReference.objectNumber,myReference.objectConst));    
      break;
      case 2:
        printObjectName(getObjectName(myTarget.objectPreFixNameNo,myTarget.objectNumber,myTarget.objectConst));
        //if (statusLX200 != 2) printObjectName(getObjectName(myTarget.objectPreFixNameNo,myTarget.objectNumber,myTarget.objectConst));
        //else lcd.print(F("external")); // if connection to LX200 source - no usage of internal star database
      break;
      case 3:
        lcd.print(getSetregionName());
       // if (statusLX200 != 2) lcd.print(getSetregionName());
       // else lcd.print(F("external"));
      break;
      case 4:
        lcd.print(getCurrentConstName());
       // if (statusLX200 != 2) lcd.print(getCurrentConstName());
       // else lcd.print(F("external"));
      break;
      case 8:   
            if (statusLX200 == 0) lcd.print(F("BT off"));
            if (statusLX200 == 1) lcd.print(F("BT on"));
            if (statusLX200 == 2) lcd.print(F("conn"));
      break;
    }

    lcd.setCursor(1,1);
    if (myMenuTopicNo + 1 < menuTopic_size)
    {
      lcd.print(menuTopic[myMenuTopicNo + 1]);
    }
    else
    {
      lcd.print(menuTopic[0]);
    }
  }

  if (myDisplayMode == 2)  
  {
    lcd.print(F("Direction of DEC"));
    lcd.setCursor(0,1);
    lcd.print(F(">"));
    if (myDirectionDEC == 1) lcd.print(F("normal"));
    else lcd.print(F("reverse"));
  }
  if (myDisplayMode == 3)  
  {
    printObjectName(getObjectName(myReference.objectPreFixNameNo,myReference.objectNumber,myReference.objectConst));
    
    lcd.setCursor(13,0);
    lcd.print(getConstName(myReference.objectConst));
    lcd.setCursor(0,1);
    lcd.print(getObjectTypeName(myReference.objectTypeMagnitude));
    lcd.setCursor(13,1);
    lcd.print(getMagnitude(myReference.objectTypeMagnitude)); 
  }
  if (myDisplayMode == 4) 
  {
    printObjectName(getObjectName(myTarget.objectPreFixNameNo,myTarget.objectNumber,myTarget.objectConst));
    
    lcd.setCursor(13,0);
    lcd.print(getConstName(myTarget.objectConst));
    lcd.setCursor(0,1);
    lcd.print(getObjectTypeName(myTarget.objectTypeMagnitude));
    lcd.setCursor(13,1);   
    lcd.print(getMagnitude(myTarget.objectTypeMagnitude));    
  }
  if (myDisplayMode == 5)
  {
    lcd.print(F("Celestial Region"));
    lcd.setCursor(0,1);
    lcd.print(F(">"));
    lcd.print(getSetregionName());
  }
  if (myDisplayMode == 6)
  {
    lcd.print(F("Constellation"));
    lcd.setCursor(11,1);
    lcd.print(getSetregionName());
    lcd.setCursor(0,1);
    lcd.print(F(">"));
    lcd.print(getCurrentConstName());
  }
  if (myDisplayMode == 7)
  {
    lcd.print(F("LCD Brightness"));
    lcd.setCursor(0,1);
    lcd.print(F(">"));
    lcd.print(myLCDbacklight);
  }
  if (myDisplayMode == 8)
  {
    lcd.print(F("LCD Contrast"));
    lcd.setCursor(0,1);
    lcd.print(F(">"));
    lcd.print(myLCDcontrast);
  }

  if (myDisplayMode == 9)
  {
    lcd.print(F("For test"));
    lcd.setCursor(0,1);
    lcd.print(F("turn DEC / RA"));
    myImpulseRA = 0; 
    myImpulseDEC = 0;
    myLastImpulseRA = 0;
    myLastImpulseDEC = 0;
  }

  if (myDisplayMode == 10)
  {
    lcd.print(F("LX200 Connection"));
    lcd.setCursor(0,1);
    lcd.print(F(">"));
    if (statusLX200 == 0) lcd.print(F("Bluetooth off"));
    if (statusLX200 == 1) lcd.print(F("Bluetooth on"));
    if (statusLX200 == 2) lcd.print(F("LX200 connected"));
  }
}

// returns name of deep sky object based on coded name its number and its constellation
String getObjectName(byte objectprefixNameNo,unsigned int objectNumber,byte objectConst)
{
  String objectName = "";
  int indexOfHash = -1;
  DSONameStruct oneDSONameStruct;

  if (objectprefixNameNo > 0)
  {
    // get name accordng to name number from lookup table
    memcpy_P (&oneDSONameStruct,&DSO_NAME_PROGMEM[objectprefixNameNo-1],sizeof oneDSONameStruct);
    objectName = oneDSONameStruct.objectName;

    indexOfHash = objectName.indexOf('#');

    if (indexOfHash > -1)
    {
      // replace char with greek char
      String charToReplace = objectName.substring(indexOfHash+1,indexOfHash+2);

      objectName = objectName.substring(0,indexOfHash) + objectName.substring(indexOfHash+2); // delete # and next char from string 

      // loop over the greek symbols 
      for (int i; i < greekSymbols_size; i++)
      {       
        if ((String)charToReplace == (String)greekSymbols[i].originalChar)
        {
          charToReplace = greekSymbols[i].replaceChar;
          objectName = objectName + charToReplace;
          break;
        }   
      }
    }    
  }
  if (objectNumber > 0)
  {
    objectName = objectName + (String)objectNumber;
  }

  // if object is only number,greek Symbol or max. two characters,accept 'M' - add constellation for identification
  if (objectName.charAt(1) == NULL || objectprefixNameNo == 0 || (objectName.charAt(2) == NULL && objectNumber == 0)) // oder nur Zahlen!!!
  {
    objectName = objectName + ' ' + getConstName(objectConst); 
  }
  
  return objectName;
}

// some greek symbols are custom, print function needed
void printObjectName(String objectName)
{
  byte customChar = 0;
  char charAt0 = objectName.charAt(0);
  
  if (charAt0 == ch_def_1) customChar = 1;
  else if (charAt0 == ch_def_2) customChar = 2;
  else if (charAt0 == ch_def_3) customChar = 3;
  else if (charAt0 == ch_def_4) customChar = 4;
  else if (charAt0 == ch_def_5) customChar = 5;
  else if (charAt0 == ch_def_6) customChar = 6;
  else if (charAt0 == ch_def_7) customChar = 7;

  if (customChar > 0) lcd.write(customChar);
  else 
  {
    lcd.print(objectName);
    return;
  }
  lcd.print(F(" "));
  lcd.print(objectName.substring(2,8));
}
//###############################################################################################################
// \display information
//###############################################################################################################

//###############################################################################################################
// switching 
//###############################################################################################################
// myDisplayMode - rotary encoder for change
// 0 = welcome, 1 = top menu, 2 = change direction, 3 = set reference, 4 = set target, 5 = set region, 6 = set constellation, 7 = set LCD brightness, 8 = set LCD contrast
// 9 = sensor test, 10 = set bluetooth, 11 = show current position, 12 = show target position, 13 = show difference target - current position
void switchMode()
{
  saveSettingsToEeprom(); // save settings to eeprom each time the button is pressed
  
  if (myDisplayMode == 0) // welcome
  {
    myDisplayMode = 1; // top menue
  }
  else if (myDisplayMode == 1)
  {
    myDisplayMode = myMenuTopicNo + 2;
  }
  else if (myDisplayMode == 3) // set reference
  {
    resetSensorTime();
    myLastDECsec = 0; // set once to zero to update display
    myDisplayMode = 11; // show current position
  }
  else if (myDisplayMode == 4) // set target 
  {
    setTargetRA_DEC(); 
    myDisplayMode = 13; // show diff position
  }
  // set direction // region // constellation // set brightness  // set contrast // sensor test // show current position // show diff position
  else if (myDisplayMode == 2 || myDisplayMode >= 5) 
  {
    myDisplayMode = 1; // return to top level menu
  } 
  lcd.clear();
}

// function of rotary encoder changes acording to current display mode
void switchSelection(int dir)
{
  if (myDisplayMode == 0)
  { 
    myDisplayMode = 1;
    updateLCD();
  }
  else if (myDisplayMode == 1) changeMenu(dir);
  if (myDisplayMode == 2) changeDirectionDEC(dir);
  if (myDisplayMode == 3) changeReference(dir);
  if (myDisplayMode == 4) changeTarget(dir);
  if (myDisplayMode == 5) changeregion(dir);
  if (myDisplayMode == 6) changeConstellation(dir);
  if (myDisplayMode == 7) changeLCDBacklight(dir); 
  if (myDisplayMode == 8) changeLCDcontrast(dir);
  if (myDisplayMode == 10) changeBTconnection(dir);
  if (myDisplayMode == 11 || myDisplayMode == 12 ||myDisplayMode == 13) changeView(dir);

  updateLCD();
}

// change menu topics
void changeMenu(int dir)
{
  if (dir == 1)
  {
    if ((myMenuTopicNo + 1) < menuTopic_size)
    {
      myMenuTopicNo = myMenuTopicNo + 1;
    }
    else 
    {
      myMenuTopicNo = 0;
    }
  }
  else if (dir == -1)
  {
    if (myMenuTopicNo > 0)
    {
      myMenuTopicNo = myMenuTopicNo - 1;
    }
    else 
    {
      myMenuTopicNo = menuTopic_size - 1;
    }
  }
}

// according to the direction of the DEC axis the value of the DEC sensor has to be reverted
void changeDirectionDEC(int dir)
{   
  if (dir == 1 || dir == -1)
  {
    if (myDirectionDEC == 1) myDirectionDEC = -1;
    else myDirectionDEC = 1;
  }
}

// calls changeObject for object type reference
void changeReference (int dir)
{
  changeObject(dir,'r');
}

// calls changeObject for object type target
void changeTarget(int dir)
{
  changeObject(dir,'t');
}

// change referenc star including filter according to selected sky region
void changeObject (int dir,char objectType)
{
  bool constFound = false;   
  DSOstruct oneObject; // instance of reference for search & filter
  unsigned int objectNo;
  unsigned int numberOfLoops = 0;
  
  if (objectType == 'r')
  {
    objectNo = myRefNo; // set start no of object
  }
  else
  {
    objectNo = myTargetNo;
  }

  while (constFound == false)  
  {
    if (dir == 1)
    {
      if ((objectNo + 1) < DSO_PROGMEM_size) 
      {
      objectNo = objectNo + 1;
      }
      else 
      {
        objectNo = 0;
      }
    }
    if (dir == -1) // before else if - but what if no fitting star at beginning before rotary turning?
    {
      if (objectNo > 0)
      {
        objectNo = objectNo - 1;
      }
      else 
      {
        objectNo = DSO_PROGMEM_size - 1;
      }
    }
    
    memcpy_P (&oneObject,&DSO_PROGMEM[objectNo],sizeof oneObject); // get next DSO object from struct and copy it into oneObject

    // filter on a constellation
    // if a constellation is selected,object is a target and constellation of object fits to selected constellation
    if (objectType == 't' && myConstellationNo > 0 && getObjectType(oneObject.objectTypeMagnitude) > 0  && getObjectType(oneObject.objectTypeMagnitude) < 12 && oneObject.objectConst == myConstellationNo)
    {
      constFound = true;
    }
    // filter on regions
    else if ( (objectType == 'r' && getObjectType(oneObject.objectTypeMagnitude) == 12) || // reference stars     // filter on objects of type "reference" = no 12
              (myConstellationNo == 0 && objectType == 't' && getObjectType(oneObject.objectTypeMagnitude) > 0  && getObjectType(oneObject.objectTypeMagnitude) < 12)) // target objects
    {
      // filter targets by constellations of the selected region
      // myregionNAME[]={"All","North","Spring","Summer","Autumn","Winter","South"};
      if (myRegionNo == 1) // region = north
      {
        for (int i = 0; i < myNorthCONST_size; i++) 
        {
          if (oneObject.objectConst == myNorthCONST[i])
          {
            constFound = true;
            break;
          }
        }
      }
      else if (myRegionNo == 2) // region = spring
      {
        for (int i = 0; i < mySpringCONST_size; i++)
        {
          if (oneObject.objectConst == mySpringCONST[i])
          {
            constFound = true;
            break;
          }
        }
      }
      else if (myRegionNo == 3) // region = summer
      {
        for (int i = 0; i < mySummerCONST_size; i++)
        {
          if (oneObject.objectConst == mySummerCONST[i])
          {
            constFound = true;
            break;
          }
        }
      }
      else if (myRegionNo == 4) // region = autumn
      {
        for (int i = 0; i < myAutumnCONST_size; i++)
        {
          if (oneObject.objectConst == myAutumnCONST[i])
          {
            constFound = true;
            break;
          }
        }
      }
      else if (myRegionNo == 5) // region = winter
      {
        for (int i = 0; i < myWinterCONST_size; i++)
        {
          if (oneObject.objectConst == myWinterCONST[i])
          {
            constFound = true;
            break;
          }
        }
      }
     else if (myRegionNo == 6) // region = south
      {
        for (int i = 0; i < mySouthCONST_size; i++)
        {
          if (oneObject.objectConst == mySouthCONST[i])
          {
            constFound = true;
            break;
          }
        }
      }
      else // all constellations
      {
        constFound = true;
      }
    }
  }// end while

  if (objectType == 'r')
  {
    myRefNo = objectNo; 
    myReference = oneObject; // copy selected reference object in my reference object
    setReferenceRA_DEC();
  }
  else
  {
    myTargetNo = objectNo;
    myTarget = oneObject; // copy selected target object in my target object
    setTargetRA_DEC();
  }
  updateLCD();
}

// change region
void changeregion(int dir)
{
  if (dir == 1)
  {
    if ((myRegionNo + 1) < regionArraySize){
      myRegionNo = myRegionNo + 1;
    }
    else {
      myRegionNo = 0;
    }
  }
  else if (dir == -1)
  {
    if (myRegionNo > 0){
      myRegionNo = myRegionNo - 1;
    }
    else {
      myRegionNo = regionArraySize-1;
    }
  } 
  myTargetNo = 0; // reset target,when aera has changed
  myConstellationNo = 0; // reset constellation,when aera has changed 
  updateLCD();
}

// set constellation
void changeConstellation(int dir)
{
  bool constFound = false; 
  while (constFound == false)  
  {
     if (dir == 1)
    {
      if ((myConstellationNo) < constStruct_size - 1){
        myConstellationNo = myConstellationNo + 1;
      }
      else {
        myConstellationNo = 0;
      }
    }
    else if (dir == -1)
    {
      if (myConstellationNo > 0){
        myConstellationNo = myConstellationNo - 1;
      }
      else {
        myConstellationNo = constStruct_size - 1;
      }
    } 
    
    // filter targets by constellations of the selected region
    // myregionNAME[]={"All","North","Spring","Summer","Autumn","Winter","South"};
    if (myRegionNo == 1) // region = north
    {
      for (int i = 0; i < myNorthCONST_size; i++)
      {
        if (myConstellationNo == myNorthCONST[i])
        {
          constFound = true;
          break;
        }
      }
    }
    else if (myRegionNo == 2) // region = spring
    {
      for (int i = 0; i < mySpringCONST_size; i++)
      {
        if (myConstellationNo == mySpringCONST[i])
        {
          constFound = true;
          break;
        }
      }
    }
    else if (myRegionNo == 3) // region = summer
    {
      for (int i = 0; i < mySummerCONST_size; i++)
      {
        if (myConstellationNo == mySummerCONST[i])
        {
          constFound = true;
          break;
        }
      }
    }
    else if (myRegionNo == 4) // region = autumn
    {
      for (int i = 0; i < myAutumnCONST_size; i++)
      {
        if (myConstellationNo == myAutumnCONST[i])
        {
          constFound = true;
          break;
        }
      }
    }
    else if (myRegionNo == 5) // region = winter
    {
      for (int i = 0; i < myWinterCONST_size; i++)
      {
        if (myConstellationNo == myWinterCONST[i])
        {
          constFound = true;
          break;
        }
      }
    }
   else if (myRegionNo == 6) // region = south
    {
      for (int i = 0; i < mySouthCONST_size; i++)
      {
        if (myConstellationNo == mySouthCONST[i])
        {
          constFound = true;
          break;
        }
      }
    }
    else // all constellations
    {
      for (int i = 0; i < myAllCONST_size; i++)
      {
        if (myConstellationNo == myAllCONST[i])
        {
          constFound = true;
          break;
        }
      }
    }
  }
  myTargetNo = 0; // reset target every time when constellation was changed
  updateLCD();
}

// switch view between current position, diff position & target coordinates
void changeView(int dir)
{
  lcd.clear();
  myDisplayMode = myDisplayMode + dir;
  if (myDisplayMode > 13) myDisplayMode = 11;
  if (myDisplayMode < 11) myDisplayMode = 13;
}

// set LCD brightness
void changeLCDBacklight(int dir)
{
  myLCDbacklight = myLCDbacklight + dir * 8;
  if (myLCDbacklight > 255) myLCDbacklight = 0;
  if (myLCDbacklight < 0) myLCDbacklight = 255;
}

// set LCD contrast
void changeLCDcontrast(int dir)
{
  myLCDcontrast = myLCDcontrast + dir * 5;
  if (myLCDcontrast > 255) myLCDcontrast = 0;
  if (myLCDcontrast < 0) myLCDcontrast = 255;
  analogWrite(LCD_CONTRAST_PIN,myLCDcontrast); 
}

// 0 - BT switched off / 1 - BT switched on
void changeBTconnection(int dir)
{
  if (btStatus == 0) // switch BT on if off
  {
    btStatus = 1;
    statusLX200 = 1;
    digitalWrite(BT_SWITCH, HIGH);
  }
  else if (btStatus != 0) // switch BT off
  {
    btStatus = 0;
    statusLX200 = 0;
    digitalWrite(BT_SWITCH, LOW);
  } 
  updateLCD();
}
//###############################################################################################################
// \switching 
//###############################################################################################################

//###############################################################################################################
// LX200 communication
//###############################################################################################################

// set the status of LX200 to control LCD etc
void updateLX200Status()
{
  // 0 - BT switched off / 1 - BT switched on 
  if (btStatus == 1)
  {
    // if frequent feedback from LX200 - last request > 4 sek 
    if ((millis() - lastLX200Message) > 4000) 
    {
      statusLX200 = 1; // BT on - but no LX200 connection
    }
    else
    {
      statusLX200 = 2; // LX200 connected
    }
  }

  // LX200 status changend - update lcd in relevant views (main menu & BT)
  if (statusLX200 != statusLX200old && (myDisplayMode == 10 || myDisplayMode == 1))
  {  
    updateLCD();
    statusLX200old = statusLX200;
  }
}

// called if a LX200 message was received
void receivedLX200message() // received
{ 
  lastLX200Message = millis();
}

// read the bluetooth message and trigger functions according to message type
void readSendLX200()
{
  if (Serial.available()) 
  {
    char message[14] = "";
    byte i = 0; 
    while (Serial.available()>0)
    { 
      char a=Serial.read(); // Stores current byte
      message[i] += a;      // Append current byte to message String
      delay(10);
      i++;
    }

    // all LX200 info from https://www.meade.com/support/TelescopeProtocol_2010-10.pdf
    // LX200 message :GR# 
    // Get Telescope RA
    // Returns: HH:MM.T#  or  HH:MM:SS#Depending which precision is set for the telescope
    if (message[0] == ':' && message[1] == 'G' && message[2] == 'R' && message[3] == '#')
    { 
      receivedLX200message();
      sendLX200RA();
    }
    
    // LX200 message :GD# or :RS#:GD# or :RM#:GD#
    // Get Telescope Declination.
    // Returns: sDD*MM# or sDD*MM’SS#Depending upon the current precision setting for the telescope.
    if (message[0] == ':' && message[1] == 'G' && message[2] == 'D' && message[3] == '#' ||
       message[4] == ':' && message[5] == 'G' && message[6] == 'D' && message[7] == '#')
    {
      receivedLX200message();
      sendLX200DEC();
    }

    // LX200 message :CM#     
    // Synchronizes the telescope's position with the currently selected database object's coordinates.
    // Returns:LX200's - a "#" terminated string with the name of the object that was synced
    if(message[0]==':' && message[1]=='C' && message[2]=='M')
    {
      receivedLX200message();
      Serial.print("#"); 
    }

    // LX200 message :SrHH:MM.T# or :SrHH:MM:SS# 
    // Set target object RA to HH:MM.T or HH:MM:SS depending on the current precision setting.
    // Returns:0 – Invalid1 - Valid
    // output HHMM(S/6)
    if(message[0]==':' && message[1]=='S' && message[2]=='r')
    {
      setRAtoLX200message(message);  
    }

    // LX200 message :SdsDD*MM# 
    // Set target object declination to sDD*MM or sDD*MM:SS depending on the current precision setting
    // Returns:1 - Dec Accepted0 – Dec invalid
    // output sHHMM 
    if(message[0]==':' && message[1]=='S' && message[2]=='d')
    {
      setDECtoLX200message(message);
    }  
    //  Serial.print("BT message "); // for debugging
    //  Serial.println(message);
  }
}

// set RA coordinates of placeholder externalobject to received LX200 message
void setRAtoLX200message(char message[10])
{
  externalObject.objectRA = 
    long(atoi(message+3))*1000 + // HH // access at array different when using atoi - use address
    long(atoi(message+6))*10; // MM - Minuten passen noch nicht bei zweistelligen gibt es Fehler

  if(message[8] == ':') // : or .
  {
    externalObject.objectRA = externalObject.objectRA + 
    long(atoi(message+9))/6; // SS/6
  }
  else if(message[8] == '.')
  {
    externalObject.objectRA = externalObject.objectRA + atoi(message+9); // T
  }
  Serial.println(); // leave this command, as otherwise no update on goto from LX200 source
}

// set DEC coordinates of placeholder externalobject to received LX200 message & update the (reference or target) object
void setDECtoLX200message(char message[9])
{
  int sign;
  if (message[3] == '-') sign = -1;
    else sign = 1;

  externalObject.objectDEC =
    sign * ( // s
    long(atoi(message+4))*100 + // DD  
    long(atoi(message+7))); // MM

  // assumption - first RA then DEC - then set target to external object
  if (myDisplayMode == 3 || myDisplayMode == 11) // if view shows reference selection or current position then copy external object into reference object
  {
    externalObject.objectTypeMagnitude = 168;
    myReference = externalObject; // copy external object to my reference object
    setReferenceRA_DEC();
    resetSensorTime();
  }
  else // in all other cases copy to target
  {
    externalObject.objectTypeMagnitude = 182; 
    myTarget = externalObject; // copy external object to my target object
    setTargetRA_DEC();
  }
  updateLCD();
}

// send current RA coordinate of telescope from SpotNik to LX200 server (e.g. Sky Safari)
void sendLX200RA()
{
  byte s = (abs(myCurrentRAsec)) % 60; // Das Zeichen: "%" ist der Modulo-Operator
  byte m  = (abs(myCurrentRAsec/60)) % 60;
  byte h  = (abs(myCurrentRAsec/3600)) % 24;
  String posString = "";

  if (h<10) posString = "0";
  posString = posString + String(h);
  posString = posString + ":";
  if (m<10) posString = posString + "0";
  posString = posString + String(m);
  posString = posString + ":";
  if (s<10) posString = posString + "0";
  posString = posString + String(s);
  posString = posString + "#";
  Serial.print(posString);     
}

// send current DEC coordinate of telescope from SpotNik to LX200 server (e.g. Sky Safari)
void sendLX200DEC()
{
  byte s = (abs(myCurrentDECsec)) % 60; // Das Zeichen: "%" ist der Modulo-Operator
  byte m = (abs(myCurrentDECsec/60)) % 60;
  byte h = (abs(myCurrentDECsec/3600)) % 180;
  String posString = "";

  if (myCurrentDECsec > 0) posString = "+";
    else posString = "-";
  if (h<10) posString = "0";
  posString = posString + String(h);
  posString = posString + "*";
  if (m<10) posString = posString + "0";
  posString = posString + String(m);
  posString = posString + "#";
  Serial.print(posString); 
}
//###############################################################################################################
// \LX200 communication
//###############################################################################################################


//###############################################################################################################
// EEPROM
//###############################################################################################################
// save relevant data for next startup (e.g. target no,LCD brightness)
void saveSettingsToEeprom()
{    
  // Serial.print(F("freeMemory()=")); //only used for testing
  // Serial.println(freeMemory());
  
  byte addr = EEPROM_VALUE_ADDR_SIGNATURE;
  byte myTargetNoLowByte = lowByte(myTargetNo); // myTargetNo is of type int - transfer into two bytes
  byte myTargetNoHighByte = highByte(myTargetNo); 
  byte myReferenceNoLowByte = lowByte(myRefNo); // myTargetNo is of type int - transfer into two bytes
  byte myReferenceNoHighByte = highByte(myRefNo); 
  
  EEPROM.update(addr,EEPROM_SIGNATURE); // use update for longer eeprom life
  addr += sizeof(EEPROM_SIGNATURE); 
  EEPROM.update(addr,myReferenceNoLowByte); 
  addr += sizeof(myReferenceNoLowByte);
  EEPROM.update(addr,myReferenceNoHighByte);
  addr += sizeof(myReferenceNoHighByte);
  EEPROM.update(addr,myTargetNoLowByte); 
  addr += sizeof(myTargetNoLowByte);
  EEPROM.update(addr,myTargetNoHighByte);
  addr += sizeof(myTargetNoHighByte);
  EEPROM.update(addr,myRegionNo);
  addr += sizeof(myRegionNo);  
  EEPROM.update(addr,myConstellationNo);
  addr += sizeof(myConstellationNo);  
  EEPROM.update(addr,myLCDbacklight);
  addr += sizeof(myLCDbacklight);
  EEPROM.update(addr,myLCDcontrast);   
}

// load relevant data at startup (e.g. target no, LCD brightness)
void getSettingsFromEeprom()
{   
  byte addr = EEPROM_VALUE_ADDR_SIGNATURE,signature = 0,value,myReferenceNoLowByte,myReferenceNoHighByte,myTargetNoLowByte,myTargetNoHighByte; // myTargetNo is of type int,need to concatenated from two bytes
  EEPROM.get(addr,signature);   
  if (signature != EEPROM_SIGNATURE) return; // maybe data from another sketch 
  addr += sizeof(EEPROM_SIGNATURE); 
  EEPROM.get(addr,value);
  myReferenceNoLowByte = value;
  addr += sizeof(myReferenceNoLowByte);
  EEPROM.get(addr,value);
  myReferenceNoHighByte = value;
  if (value >= 0 && value <= 32767)  myRefNo = word(myReferenceNoHighByte,myReferenceNoLowByte);
  addr += sizeof(myReferenceNoHighByte);
  EEPROM.get(addr,value);
  myTargetNoLowByte = value;
  addr += sizeof(myTargetNoLowByte);
  EEPROM.get(addr,value);
  myTargetNoHighByte = value;
  if (value >= 0 && value <= 32767)  myTargetNo = word(myTargetNoHighByte,myTargetNoLowByte);
  addr += sizeof(myTargetNoHighByte);
  EEPROM.get(addr,value); 
  if (value >= 0 && value <= 255) myRegionNo = value;
  addr += sizeof(myRegionNo);  
  EEPROM.get(addr,value);
  if (value >= 0 && value <= 255) myConstellationNo = value;
  addr += sizeof(myConstellationNo);  
  EEPROM.get(addr,value);
  if (value >= 0 && value <= 255) myLCDbacklight = value;
  addr += sizeof(myLCDbacklight);
  EEPROM.get(addr,value);
  if (value >= 0 && value <= 255) myLCDcontrast = value; 
}
//###############################################################################################################
// \EEPROM
//###############################################################################################################
